papamidas/WROOM02_EV/README.md

# WROOM02_EV
Micropower IOT Evaluation Board: ESP8266, BME680, BME280, LM75, DS18B20 and TPL5110 nanopower timer for true low power battery operation

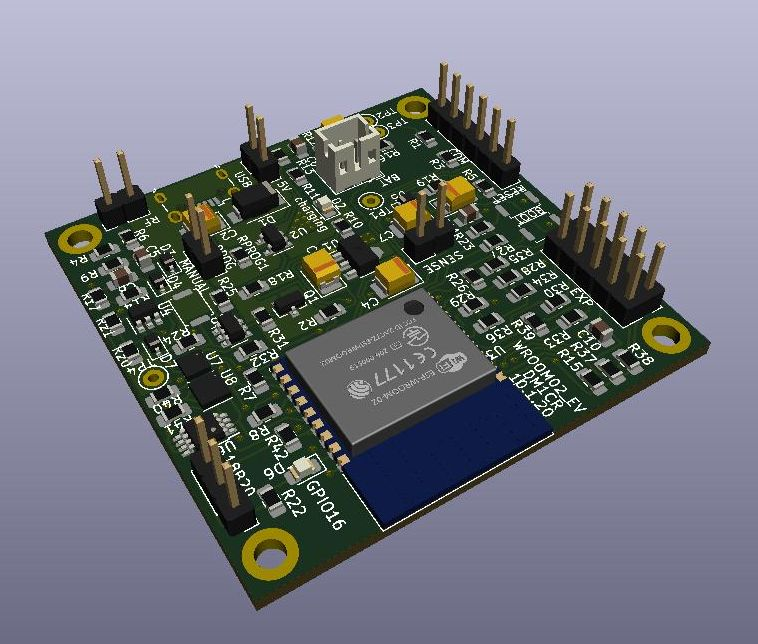
[picture p1: WROOM02_EV.jpg]
WROOM02_EV_TOP WROOM02_EV
