papamidas/WROOM02_EV/WROOM02_EV_schematic.pdf

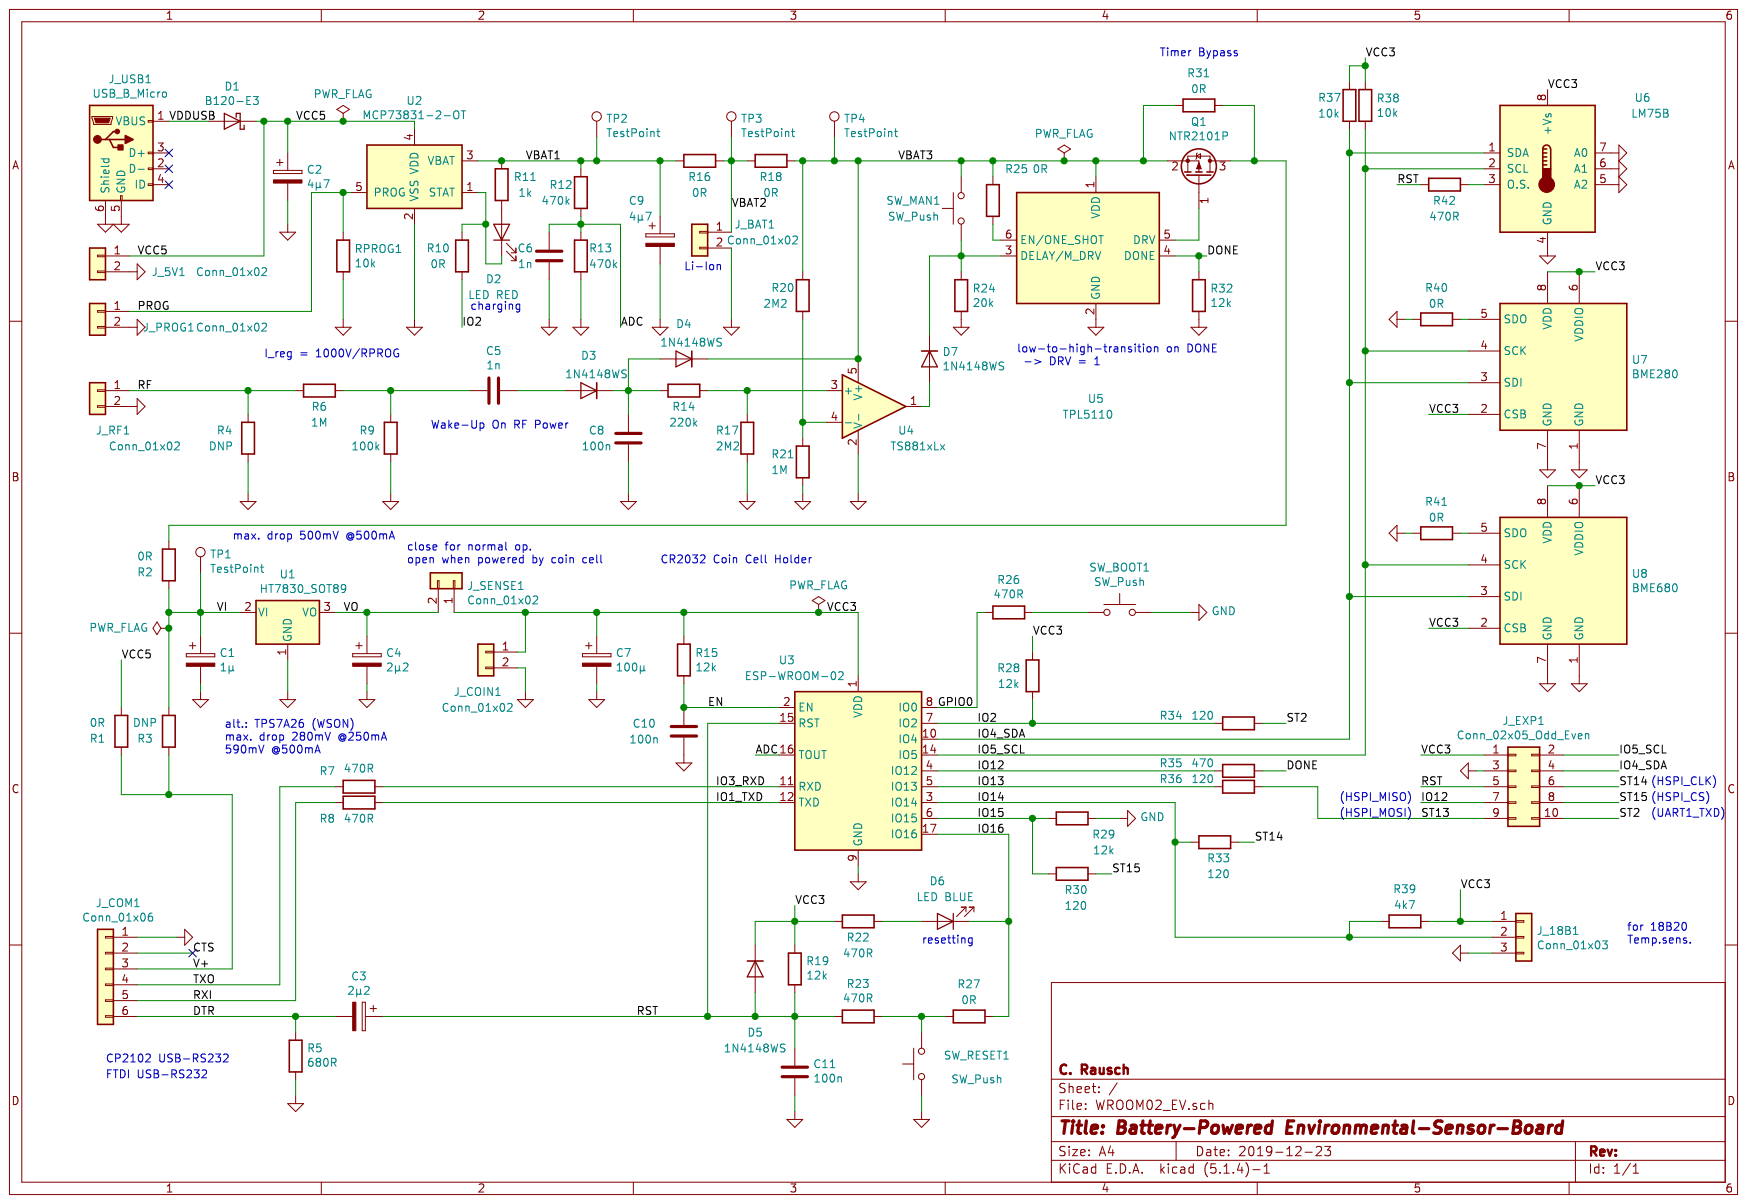
[picture p2: page 1]
