papamidas/WROOM02_EV/WROOM02_EV.kicad_pcb

## KiCad design WROOM02_EV.kicad_pcb (2020-01-11)

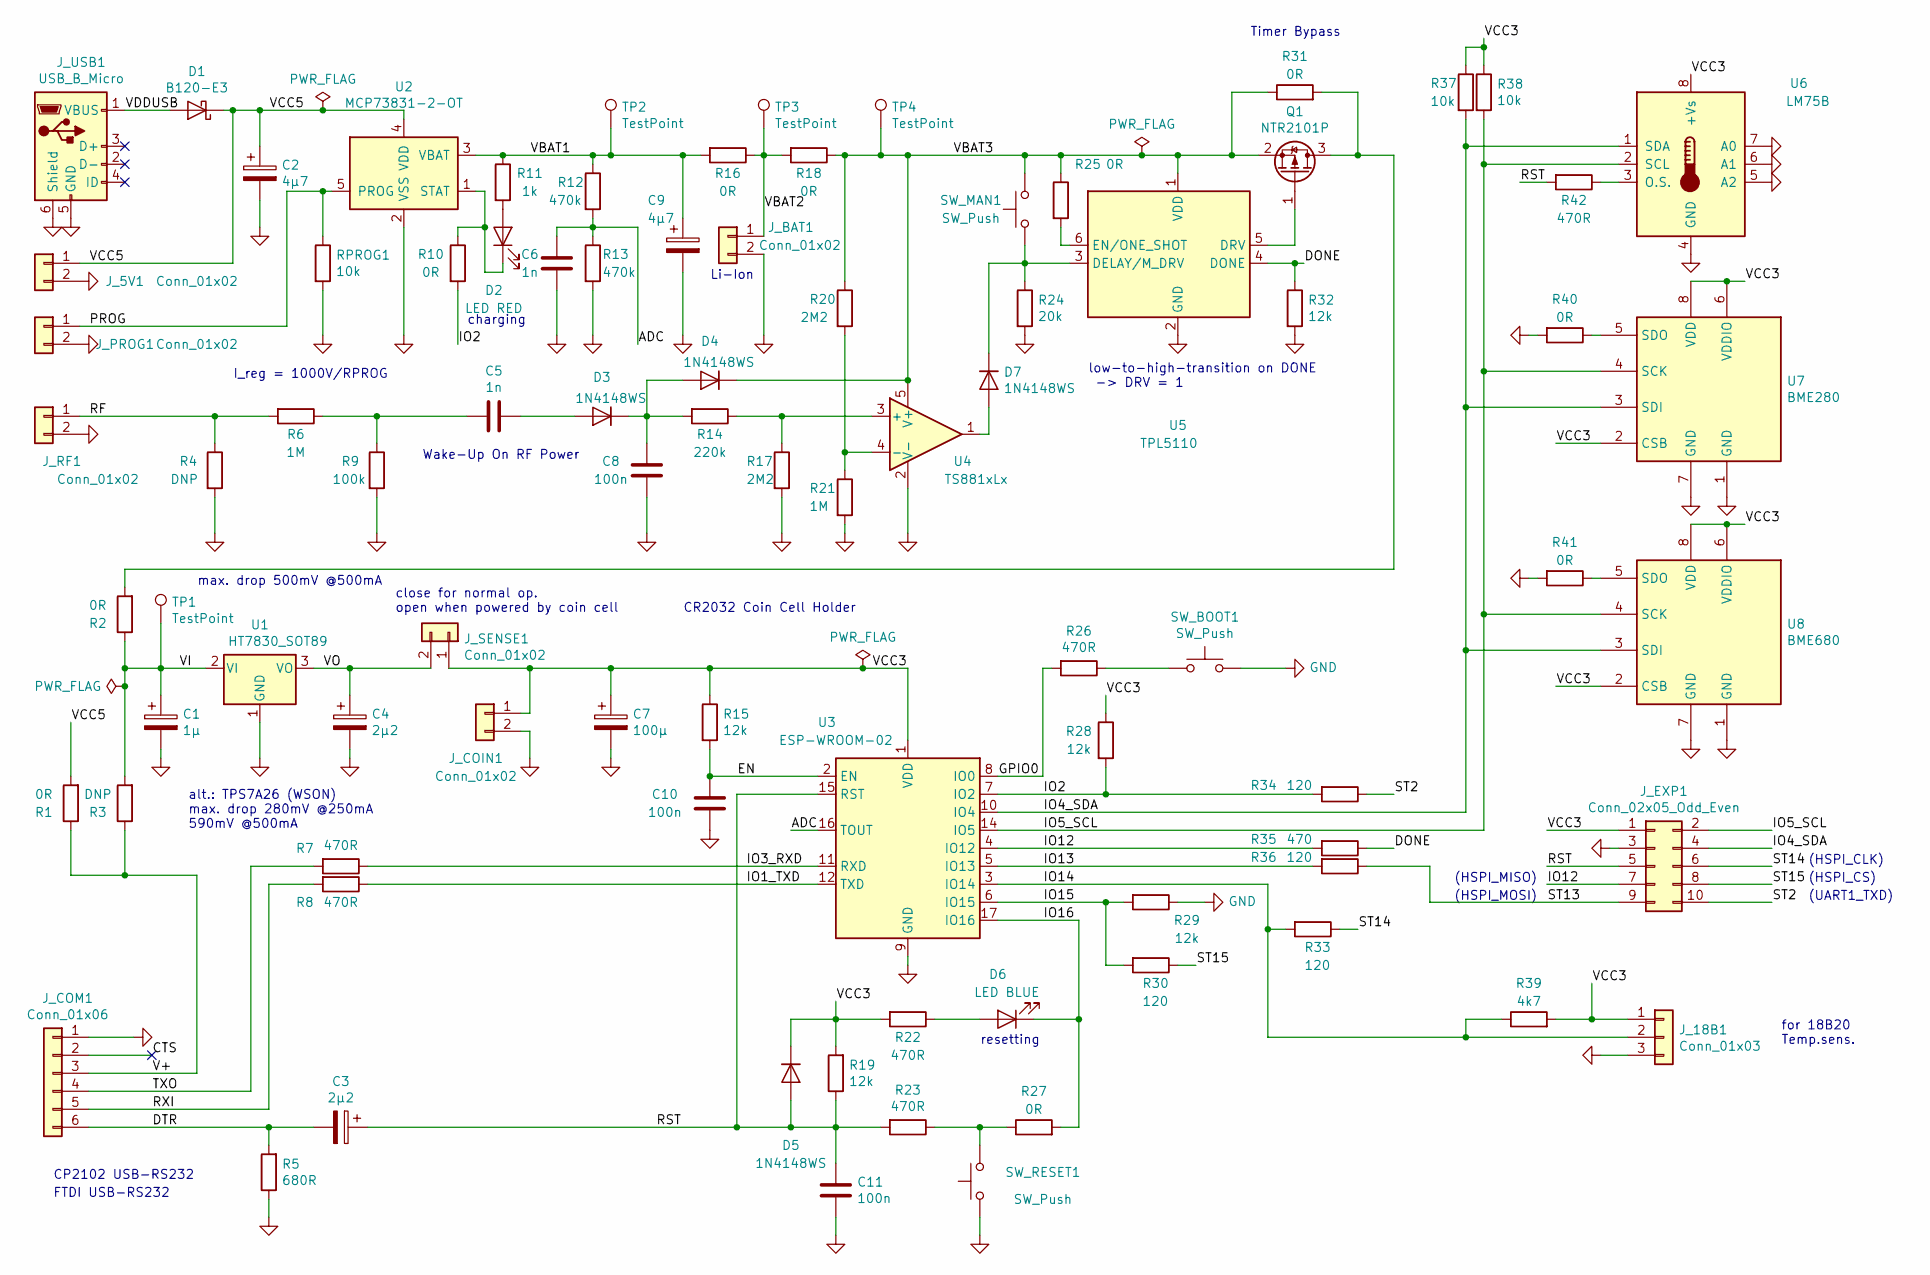
[picture p3: schematic WROOM02_EV.sch, Battery-Powered Environmental-Sensor-Board]

Parts:
C1: 1µ; CP_EIA-3528-21_Kemet-B_Pad1.50x2.35mm_HandSolder
C2, C9: 4µ7; CP_EIA-3528-21_Kemet-B_Pad1.50x2.35mm_HandSolder
C3, C4: 2µ2; CP_EIA-3528-21_Kemet-B_Pad1.50x2.35mm_HandSolder
C5, C6: 1n; C_0805_2012Metric_Pad1.15x1.40mm_HandSolder
C7: 100µ; CP_EIA-3528-21_Kemet-B_Pad1.50x2.35mm_HandSolder
C8, C10, C11: 100n; C_0805_2012Metric_Pad1.15x1.40mm_HandSolder
D1: B120-E3; D_SMA
D2: LED RED; LED_0805_2012Metric_Pad1.15x1.40mm_HandSolder
D3, D4, D5, D7: 1N4148WS; D_SOD-323
D6: LED BLUE; LED_0805_2012Metric_Pad1.15x1.40mm_HandSolder
J_5V1: Conn_01x02; PinHeader_1x02_P2.54mm_Vertical
J_18B1: Conn_01x03; PinHeader_1x03_P2.54mm_Vertical
J_BAT1: Conn_01x02; JST_PH_B2B-PH-K_1x02_P2.00mm_Vertical
J_COIN1: Conn_01x02; BatteryHolder_Keystone_1058_1x2032
J_COM1: Conn_01x06; PinHeader_1x06_P2.54mm_Vertical
J_EXP1: Conn_02x05_Odd_Even; PinHeader_2x05_P2.54mm_Vertical
J_PROG1: Conn_01x02; PinHeader_1x02_P2.54mm_Vertical
J_RF1: Conn_01x02; PinHeader_1x02_P2.54mm_Vertical
J_SENSE1: Conn_01x02; PinHeader_1x02_P2.54mm_Vertical
J_USB1: USB_B_Micro; USB_Micro-B_Wuerth_629105150521
Q1: NTR2101P; SOT-23
R1, R2, R10, R16, R18, R25, R27, R31, R40, R41: 0R; R_0805_2012Metric_Pad1.15x1.40mm_HandSolder
R3, R4: DNP; R_0805_2012Metric_Pad1.15x1.40mm_HandSolder
R5: 680R; R_0805_2012Metric_Pad1.15x1.40mm_HandSolder
R6, R21: 1M; R_0805_2012Metric_Pad1.15x1.40mm_HandSolder
R7, R8, R22, R23, R26, R42: 470R; R_0805_2012Metric_Pad1.15x1.40mm_HandSolder
R9: 100k; R_0805_2012Metric_Pad1.15x1.40mm_HandSolder
R11: 1k; R_0805_2012Metric_Pad1.15x1.40mm_HandSolder
R12, R13: 470k; R_0805_2012Metric_Pad1.15x1.40mm_HandSolder
R14: 220k; R_0805_2012Metric_Pad1.15x1.40mm_HandSolder
R15, R19, R28, R29, R32: 12k; R_0805_2012Metric_Pad1.15x1.40mm_HandSolder
R17, R20: 2M2; R_0805_2012Metric_Pad1.15x1.40mm_HandSolder
R24: 20k; R_0805_2012Metric_Pad1.15x1.40mm_HandSolder
R30, R33, R34, R36: 120; R_0805_2012Metric_Pad1.15x1.40mm_HandSolder
R35: 470; R_0805_2012Metric_Pad1.15x1.40mm_HandSolder
R37, R38: 10k; R_0805_2012Metric_Pad1.15x1.40mm_HandSolder
R39: 4k7; R_0805_2012Metric_Pad1.15x1.40mm_HandSolder
RPROG1: 10k; R_0805_2012Metric_Pad1.15x1.40mm_HandSolder
SW_BOOT1: SW_Push; SW_Push_SPST_NO_Alps_SKRK
SW_MAN1: SW_Push; SW_Push_SPST_NO_Alps_SKRK
SW_RESET1: SW_Push; SW_Push_SPST_NO_Alps_SKRK
TP1, TP2, TP3, TP4: TestPoint; TestPoint_Keystone_5000-5004_Miniature
U1: HT7830_SOT89; SOT-89-3
U2: MCP73831-2-OT; SOT-23-5
U3: ESP-WROOM-02
U4: TS881xLx; SOT-23-5
U5: TPL5110; SOT-23-6
U6: LM75B; TSSOP-8_3x3mm_P0.65mm
U7: BME280; Bosch_LGA-8_2.5x2.5mm_P0.65mm_ClockwisePinNumbering
U8: BME680; Bosch_LGA-8_3x3mm_P0.8mm_ClockwisePinNumbering

Connections:
/ADC: C6.1, R12.2, R13.1, U3.16 (TOUT)
/CTS: J_COM1.2
/DONE: R32.1, R35.1, U5.4 (DONE)
/DTR: C3.2, J_COM1.6, R5.2
/EN: C10.1, R15.2, U3.2 (EN)
/GPIO0: R26.2, U3.8 (IO0)
/IO1_TXD: R8.1, U3.12 (TXD)
/IO2: R10.2, R28.2, R34.2, U3.7 (IO2)
/IO3_RXD: R7.1, U3.11 (RXD)
/IO4_SDA: J_EXP1.4, R37.2, U3.10 (IO4), U6.1 (SDA), U7.3 (SDI), U8.3 (SDI)
/IO5_SCL: J_EXP1.2, R38.2, U3.14 (IO5), U6.2 (SCL), U7.4 (SCK), U8.4 (SCK)
/IO12: J_EXP1.7, R35.2, U3.4 (IO12)
/IO13: R36.2, U3.5 (IO13)
/IO14: J_18B1.2, R33.2, R39.1, U3.3 (IO14)
/IO15: R29.2, R30.2, U3.6 (IO15)
/IO16: D6.1 (K), R27.2, U3.17 (IO16)
/PROG: J_PROG1.1, RPROG1.1, U2.5 (PROG)
/RF: J_RF1.1, R4.1, R6.2
/RST: C3.1, C11.2, D5.2 (A), J_EXP1.5, R19.1, R23.2, R42.2, U3.15 (RST)
/RXI: J_COM1.5, R8.2
/ST2: J_EXP1.10, R34.1
/ST13: J_EXP1.9, R36.1
/ST14: J_EXP1.6, R33.1
/ST15: J_EXP1.8, R30.1
/TXO: J_COM1.4, R7.2
/V+: J_COM1.3, R1.1, R3.1
/VBAT1: C9.1, R11.1, R12.1, R16.2, TP2.1, U2.3 (VBAT)
/VBAT2: J_BAT1.1, R16.1, R18.2, TP3.1
/VBAT3: D4.1 (K), Q1.2 (S), R18.1, R20.1, R25.1, R31.1, SW_MAN1.1, TP4.1, U4.5 (V+), U5.1 (VDD)
/VCC3: C7.1, D5.1 (K), J_18B1.1, J_COIN1.1, J_EXP1.1, J_SENSE1.1, R15.1, R19.2, R22.2, R28.1, R37.1, R38.1, R39.2, U3.1 (VDD), U6.8 (+Vs), U7.2 (CSB), U7.6 (VDDIO), U7.8 (VDD), U8.2 (CSB), U8.6 (VDDIO), U8.8 (VDD)
/VCC5: C2.1, D1.1 (K), J_5V1.1, R1.2, U2.4 (VDD)
/VDDUSB: D1.2 (A), J_USB1.1 (VBUS)
/VI: C1.1, R2.1, R3.2, TP1.1, U1.2 (VI)
/VO: C4.1, J_SENSE1.2, U1.3 (VO)
GND: C1.2, C2.2, C4.2, C6.2, C7.2, C8.2, C9.2, C10.2, C11.1, J_5V1.2, J_18B1.3, J_BAT1.2, J_COIN1.2, J_COM1.1, J_EXP1.3, J_PROG1.2, J_RF1.2, J_USB1.5 (GND), J_USB1.6 (Shield), R4.2, R5.1, R9.2, R13.2, R17.2, R21.2, R24.2, R29.1, R32.2, R40.2, R41.2, RPROG1.2, SW_BOOT1.2, SW_RESET1.1, U1.1 (GND), U2.2 (VSS), U3.9 (GND), U3.13 (GND), U3.18 (GND), U3.19 (GND), U4.2 (V-), U5.2 (GND), U6.4 (GND), U6.5 (A2), U6.6 (A1), U6.7 (A0), U7.1 (GND), U7.7 (GND), U8.1 (GND), U8.7 (GND)
unnamed: C5.1, D3.2 (A)
unnamed: C5.2, R6.1, R9.1
unnamed: C8.1, D3.1 (K), D4.2 (A), R14.2
unnamed: D2.1 (K), R10.1, U2.1 (STAT)
unnamed: D2.2 (A), R11.2
unnamed: D6.2 (A), R22.1
unnamed: D7.1 (K), R24.1, SW_MAN1.2, U5.3 (DELAY/M_DRV)
unnamed: D7.2 (A), U4.1
unnamed: Q1.1 (G), U5.5 (DRV)
unnamed: Q1.3 (D), R2.2, R31.2
unnamed: R14.1, R17.1, U4.3 (+)
unnamed: R20.2, R21.1, U4.4 (-)
unnamed: R23.1, R27.1, SW_RESET1.2
unnamed: R25.2, U5.6 (EN/ONE_SHOT)
unnamed: R26.1, SW_BOOT1.1
unnamed: R40.1, U7.5 (SDO)
unnamed: R41.1, U8.5 (SDO)
unnamed: R42.1, U6.3 (O.S.)

Notes on the sheet:
FTDI USB-RS232
CP2102 USB-RS232
CR2032 Coin Cell Holder
Li-Ion
close for normal op. open when powered by coin cell
Timer Bypass
for 18B20 Temp.sens.
low-to-high-transition on DONE -> DRV = 1
Wake-Up On RF Power
(HSPI_MISO)
(HSPI_MOSI)
(HSPI_CS)
(UART1_TXD)
I_reg = 1000V/RPROG
(HSPI_CLK)
alt.: TPS7A26 (WSON) max. drop 280mV @250mA 590mV @500mA
max. drop 500mV @500mA
charging
resetting

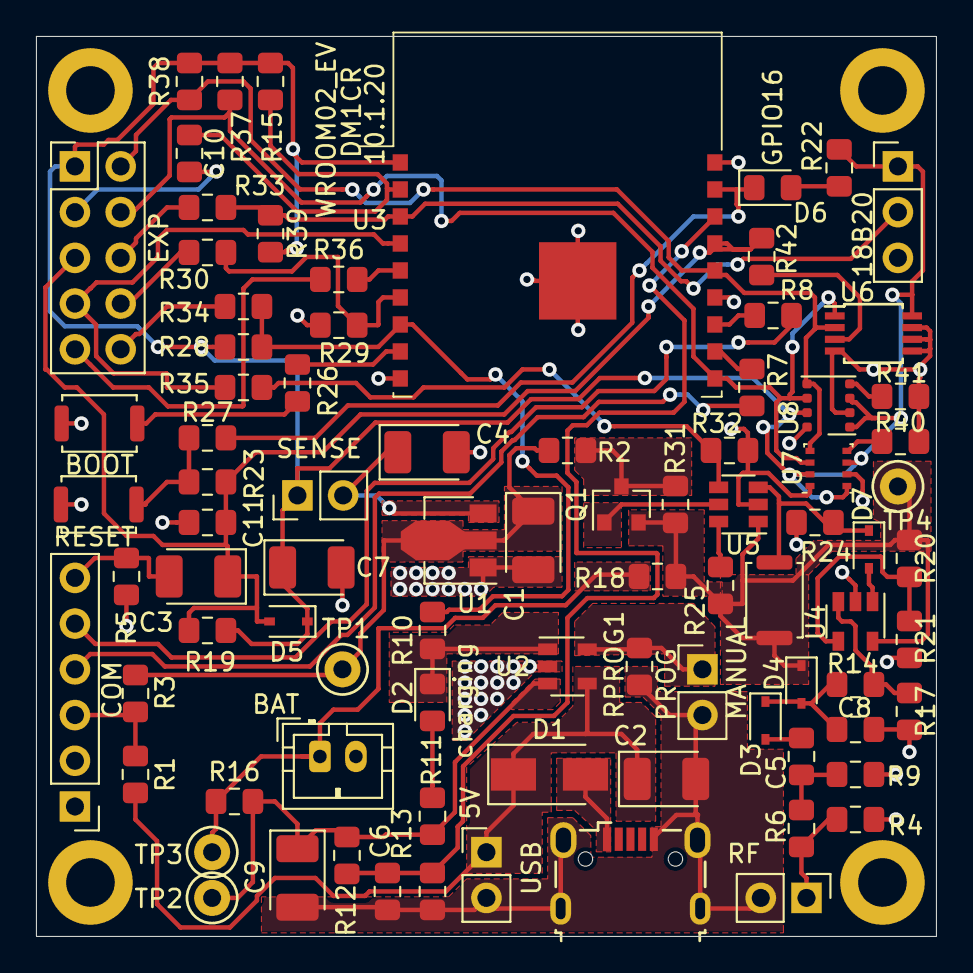
[picture p4: board WROOM02_EV.kicad_pcb from above]

Board: 2 copper layers, 50.0 x 50.0 mm, 87 parts (1 on the bottom side), 52 nets.
