papamidas/WROOM02_EV/(commit log)

2020-01-11 First version, uploaded to JLC
    [WROOM02_EV-B_Cu.gbr, WROOM02_EV-B_Mask.gbr, WROOM02_EV-B_SilkS.gbr, WROOM02_EV-Edge_Cuts.gbr, WROOM02_EV-F_Cu.gbr, WROOM02_EV-F_Mask.gbr, WROOM02_EV-F_SilkS.gbr, WROOM02_EV-NPTH.drl]
2020-01-11 schematic pdf output added
2020-01-11 3d view of board added
